aesc-silicon/ElemRV/software/elemrv_s/coremark/core_portme.h

/*
 * SPDX-FileCopyrightText: 2026 aesc silicon
 *
 * SPDX-License-Identifier: Apache-2.0
 */

#ifndef CORE_PORTME_H
#define CORE_PORTME_H

/* ElemRV-H is rv32i_zicsr: no F/D extension and no Zicntr, so floating point
 * is avoided entirely and timing comes from the machine timer instead of
 * mcycle. portable_fini() prints the raw tick count and the timer frequency so
 * the score can be recomputed at full precision on the host.
 */
#define HAS_FLOAT  0
#define HAS_TIME_H 0
#define USE_CLOCK  0
#define HAS_STDIO  0
#define HAS_PRINTF 0

#define COMPILER_VERSION "GCC" __VERSION__
#ifndef COMPILER_FLAGS
#define COMPILER_FLAGS FLAGS_STR
#endif
#define MEM_LOCATION "STACK"

typedef signed short   ee_s16;
typedef unsigned short ee_u16;
typedef signed int     ee_s32;
typedef double         ee_f32;
typedef unsigned char  ee_u8;
typedef unsigned int   ee_u32;
typedef ee_u32         ee_ptr_int;
typedef unsigned int   ee_size_t;
#define NULL ((void *)0)

#define align_mem(x) (void *)(4 + (((ee_ptr_int)(x)-1) & ~3))

#define CORETIMETYPE ee_u32
typedef ee_u32 CORE_TICKS;

#ifndef SEED_METHOD
#define SEED_METHOD SEED_VOLATILE
#endif

#ifndef MEM_METHOD
#define MEM_METHOD MEM_STACK
#endif

#ifndef MULTITHREAD
#define MULTITHREAD 1
#define USE_PTHREAD 0
#define USE_FORK    0
#define USE_SOCKET  0
#endif

/* No argc/argv from start.s, and _kernel() ignores the return value. */
#define MAIN_HAS_NOARGC   1
#define MAIN_HAS_NORETURN 0

extern ee_u32 default_num_contexts;

typedef struct CORE_PORTABLE_S
{
	ee_u8 portable_id;
} core_portable;

void portable_init(core_portable *p, int *argc, char *argv[]);
void portable_fini(core_portable *p);

#if !defined(PROFILE_RUN) && !defined(PERFORMANCE_RUN) \
	&& !defined(VALIDATION_RUN)
#if (TOTAL_DATA_SIZE == 1200)
#define PROFILE_RUN 1
#elif (TOTAL_DATA_SIZE == 2000)
#define PERFORMANCE_RUN 1
#else
#define VALIDATION_RUN 1
#endif
#endif

int ee_printf(const char *fmt, ...);

#endif /* CORE_PORTME_H */
