aesc-silicon/ElemRV/(commit log)

2024-12-31 Update Project
    * Move to Taskfile for better handling both FPGA/ASIC flows
    * Move ElemRV into this repository
    * Add manifest with all dependencies
    * Add github workflow to run minimal DRC checks
2025-02-12 Update to elements:v1.2
    * Update ORFS and Zibal in manifest
    * Switch from elements:v1.2 to v1.2
    * Add check-logs command to Taskfile
2025-03-05 hardware: elemrv: Update Board for Simulation
    Update HyperRAM and SPI Flash to proper simulate that chip.
2025-04-14 hardware: Update to ElemRV-N 0.2
    * Reduce clock from 25 to 20 MHz
    * Add pinmuxing with 20 general pins
    * Add more interfaces:
    * I2C Controller
    * PWM
    * PIO
    * Add masked AES accelerator
2025-04-14 hardware: elemrv: Update Demo Software
    Since the HyperBus controller got fixed, we can now run
    software in external HyperRAM.
    [kernel.c]
2025-12-04 Switch to Travis CI
    Move the "Check Design Flow from RTL to GDS" from GitHub
    to Travis CI.
    GitHub has only limited space size and this action is running
    out of space when installing the container.
2025-12-11 hardware: elemrv_h: Increase OCRAM to 8kB
    Switch from a 4 Macros to a 1 Macro SRAM macro. Additionally,
    increase the overall OCRAM size from 4 to 8kB.
2025-12-16 software: Switch to SPI XIP Quad IO protocol
    Switch as early as possible to the Quad IO protocol to
    improve the overall SPI bandwidth on the SPI XIP interface.
2025-12-16 manifest: Bump Nafarr and Zibal
    Include the SPI XIP Quad I/O protocol feature.
2025-12-17 hardware: elemrv_n: ECPIX5: Add SPI flash reset
    Add a reset generator for the external SPI flash.
2025-12-17 software: elemrv_n: Switch stack location to HyperRAM
    Switch the stack location from the internal OCRAM to the external
    HyperRAM.
    Also disable SPI Quad I/O for the Nitrogen architecture.
2025-12-18 hardware: ElemRV-*: ECPIX5: Add missing SPI rst signal
    This signal is required for the FPGA-based simulation.
2025-12-18 manifests: Bump Nafarr and Zibal
    * Add missing SRAM PDN to global PDN connection.
    * Improve SPI initial frequency from 1 to 5 MHz.
    * Simplify ECP5-based PLL interface.
2025-12-21 manifests: Remove gdsiistl
    We now have a Blender Add-on [1] to import GDSII files directly.
    Therefore remove gdsiistl because we don't need to convert the
    GDSII layout to STL first.
    1: https://github.com/aesc-silicon/BlenderGDS
2026-03-23 software: Add image container scripts
    Add scripts to generate an image container to boot from SPI flash.
2026-03-23 software: elemrv_n: Update bootrom
    * Enable SPI Quad I/O
    * Use different LED (then application)
    * Turn off all LEDs after relocating software
    * Add uart_putc for debugging
    * Decrease application size to reloacte faster
2026-03-23 hardware: Update ElemRV
    * Use new Clock and Reset Controllers
    * Use Edge enum instead of string
    * Move power and ground IO cells to top-level class
    * Rework clock handling
2026-03-24 Add manifest-tapeout-ihp-sg13cmos-2026-03-r1
    This revision brings several key updates to the ElemRV-N SoC:
    * Introduces a new L1 data cache and L1 instruction cache
    * Adds SPI support with Quad I/O protocol
    * Increases the chip clock frequency from 20 MHz to 60 MHz, with peripherals and CPU operating at 30 MHz
    * Migrates the bus architecture from ABMA to BMB and Wishbone
2026-05-03 Taskfile: TECH clean-up and new tasks
    Don't use TECH as BOARD name, add multiple new environment variables
    to support multiple PDKs. Also add metadata checks.
2026-05-03 Taskfile.firmware: Remove TECH and Clean-up
    Remove spaces around variables in {{ }}. Also replace TECH with board
    variable.
2026-05-03 software: ElemRV-H: Update Firmware
    * Add interrupt handling with UART loopback
    * Fix spi.layout (block size is larger)
    * Fill gen_image_container to generate a truncated image
    [kernel.c]
2026-05-03 hardware: ElemRV-H: Update Size and Clean-up
    * Reduce the die size by 18 %
    * Minor clean-ups that were missing from the last tape-out
    * Add rules.json
2026-05-04 software: elemrv_h: demo: Sync start.s
    Use "zero" when enabling XIP and add uart_putc as debug
    function.
2026-05-04 software: elemrv_h: Add bootrom
    Add the bootrom firmware back, because Zephyr currently can't
    enable XIP. It's also a cleaner boot process because Hydrogen
    and Nitrogen both use a bootrom.
2026-06-06 Fix Firmware Path
    Firmwares are now stored directly under build/<soc>/firmware because
    there should be no target specific changes. Therefore, they can live
    in a general directory. That also makes handling firmware binaries
    easier when using multiple boards in parallel (like FPGA + ASIC).
2026-06-06 Update ElemRV-H
    Switch the entire interconnect from BMB/Wishbone to TileLink for both
    the shared bus and all peripheral slave interfaces. This aligns ElemRV-H
    with the VexiiRiscv ecosystem and removes the legacy bus dependencies.
    Move the ASIC target from IHP SG13G2 to the lower-cost SG13CMOS5L
    process. Update IO cells, power pads, die/core area, and SRAM macro
    placement accordingly. The FPGA target (ECPIX5) is updated in parallel.
    Peripheral changes:
    - Migrate GPIO, UART, I2C, PIO, PWM, Pinmux from Wishbone to TileLink
    - Add system peripherals: Timer, Watchdog, ESM, Syscon
    - Add PRNG crypto peripheral
    - Add interrupt and error signal wiring for PIO, PWM, UART, PRNG
    - Rework PWM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
2026-06-06 hardware: elemrv_n: Address Nafarr/Zibal Changes
    The handling of interrupt count changed slightly in Zibal and PWM
    now has a sync and fault input signal, which should be tied to
    low by default.
2026-06-06 manifest: Bump Nafarr/Zibal + downgrade ORFS/IHP PDK
    Bump Nafarr to include the latest IP core updates with various
    improvements and TileLink support. Zibal adds a lot of changes
    to Hydrogen with a switch from BMB+Wishbone to TileLink and
    VexiiRiscv.
    Use ORFS and the IHP PDK from the Marc tape-out because both repos
    added support for CMOS5L.
2026-06-10 hardware: elemrv_h: Minor clean-up
    * Remove CRC32 import
    * Switch from genFPGASimConfig to genASICSimConfig from ASIC targets
    * Add ihpSramBlackboxes to replace generic memory against available
    IHP SRAM macros
    * Use parameter names in SoC Parameter
2026-06-10 hardware: elemrv_n: Switch from genFPGASimConfig to genASICSimConfig
    Switch from genFPGASimConfig to genASICSimConfig from ASIC targets
2026-06-11 hardware: elemrv_{h,c}: Add Reports
    The report tool generates RST tables for error, interrupt and
    pinmux options. Additionally, it generates a pinout JSON file.
2026-06-11 Update Travis Config
    Run most task for ElemRV-H, -C, and -N. Don't run the RTL to GDS
    flow since it takes too long.
2026-06-16 software: elemrv_h: Reduce bootrom size
    The Hydrogen bootrom only enables SPI Quad mode. Therefore,
    reduce the bootrom size to 4kB since that's enough for this
    task.
2026-06-19 docs: flows: chip: Remove fixed Known Issues
2026-06-19 docs: Add Virtual Prototyping
    Explain how to simulate, emulate and co-simulate a board to debug
    and develop software on virtual SoCs.
2026-06-19 podman-compose: Forward port 3456 for UART0
    Renode provides a socket with a virtual console. Forward this port
    to the host machine to allow running telnet and use the console.
2026-06-22 build: Select the ASIC target via TARGET instead of PDK/board
    The build was selected with PDK= and an implicitly derived `board`
    (e.g. SG13CMOS5L), which conflated the process node with a "board".
    Rework the model around explicit dimensions:
    - TARGET names the ASIC target (SG13CMOS5L, GF180MCU, SG13G2) and
    derives the PDK; the `board` variable is gone.
    - FPGA verification is a separate dimension: the FPGA board (ECPIX5)
    is nested under the target it verifies, both in the source tree
    (hardware/scala/<soc>/<TARGET>/ECPIX5/) and the build output
    (build/<SOC>/<TARGET>/fpga/<BOARD>/).
    - ECPIX5 tops are repackaged as <soc>.<TARGET>.ECPIX5* so multiple
    targets can each have their own FPG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
2026-07-03 Taskfile: Introduce flash namespace
    This namespace can flash a SPI flash via JTAG or flashrom
    (busbirate). It also uses smaller image sizes for JTAG and
    truncates the image to fit the SPI flash via flashrom.
2026-07-03 software: Generate 512kb images
    The total flash size is defined with 512kB in Zephyr.
    Generate images which fit this image size and truncate them
    later in case larger images are required.
2026-07-03 Taskfile: Add FLOORPLAN variable
    This variable allows to switch between a relaxed and tape-out
    floorplan. Relaxed increases the layout size and therefore improves
    the layouttime, while tape-out is more accurate.
2026-07-03 docs: Add flash namespace and FLOORPLAN variable
    Address all recent changes in the documentation to reflect the
    current tooling.
2026-07-03 hardware: ElemRV-N: Add SPI reset signal
    Make sure ElemRV-N still compiles without properly connect the
    SPI reset signal.
    ElemRV-N will be updated next.
2026-07-03 hardware: Update ElemRV-H
    * Decrease general-purpose pins from 12 to 11
    * Add SPI reset pin to reset the ext. SPI flash
    * Add reset domain to release SPI reset before CPU reset
    * Switch both 4kB SRAM macros against a single 8kB one
    * Increase debug clock domain to mach system
    * Add relaxed floorplan
2026-07-03 hardware: Update ElemRV-C
    * Place i-cache as memory (tag and data)
    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
2026-07-22 Taskfile: asic: Add precondition for build
    Print a useful error message whenever the SoC metadata
    are not existing.
2026-07-22 Taskfile: Add configurable chip top-cell name via TOPCELL
    Introduce a TOPCELL variable (default "<TARGET>Top") threaded through the
    container env into ORFS and the SpinalHDL generators, allowing the whole
    design top cell - Verilog module, DESIGN_NAME/DESIGN_NICKNAME, results dir,
    --topcell and generated files - to be renamed from one place. Apply it in the
    ElemRV-H and ElemRV-C generators via setDefinitionName + setTopCellName.
2026-07-22 Taskfile: sim: Add precondition
    Print a useful error message whenever the firmware is missing when
    running the emulation, co-simulation or simulation tasks.
2026-08-25 Taskfile: Rework debug, flash, and FPGA flows
    - jtag: add server (OpenOCD gdb:3333 + telnet:4444), telnet, and flash
    tasks, plus a debug task that attaches GDB over JTAG.
    - Fold the standalone flash Taskfile into jtag (SPI-NOR flashing via
    OpenOCD).
    - fpga: add mode=spi to program the external SPI flash (default loads
    volatile SRAM).
    - sim: gate on the generated cosim peripheral manifest (peripherals.tsv)
    with a clear "run asic:prepare first" message.
    - Add SPDX headers / task schema to the reworked files.
2026-08-25 hardware: elemrv_{h,c}: Move HyperRAM/SPI flash sim import
    The HyperRAM and SPI flash simulation objects moved from Zibal to
    Nafarr to allow round-trip tests with each controller.
2026-08-25 hardware: Update ElemRV-H and -C for the Nitrogen rework
    Bring the -C and -H SoC tops (and their FPGA/cosim configs) back in
    line with the shared platform changes:
    - Repoint imports to the relocated Nafarr models: ocram
    TileLinkIhpOnChipRam (tech-agnostic path) and spi MT25Q.
    - Declare the asynchronous clock groups via setAsynchronousClocks
    (clk_main / clk_jtag / clk_debug).
    - Emit the Renode co-simulation manifest with
    RenodeTools.dumpCosimManifest.
    - Fix the Renode .resc/.repl: privilegedArchitecture typo, and drop the
    hand-written per-peripheral SimulationFilePathLinux bindings now
    provided by the manifest.
    [kernel.c]
2026-08-25 software: Fix interrupt handling in bare-metal demos
    The interrupt handler in the bare-metal demo application was not
    working for any platform anymore. Add general fixes, enable the
    GPIO interrupt again with a configurable input pin with a better
    print.
    [kernel.c]
2026-08-25 manifests: Drop vexriscv
    ElemRV is not using vexriscv anymore and entirely switched to
    VexiiRiscv. Remove it from the manifest.
2026-08-30 manifest: Bump Zibal
    3ae591c Bump scalafmt to 2.4.6
    8aeb6ed Add Nafarr as external project
    d97ab41 eda: Lattice: Harden FPGA synthesis flow
    e56c563 Make Repo easier for contributions
    19e42bb Taskfile: lib-sealring: Swap width/length
2026-09-02 ElemRV-{H,C,N}: Add CoreMark support
    Generate the soc.h also for the "coremark" firmware and add the
    "coremark" firmware for each SoC.
    Also don't generate a soc.h file for the ElemRV-N "bootrom"
    firmware, since it doesn't require those information.
    [core_portme.c, core_portme.h, kernel.c]
2026-09-02 hardware: elemrv_{h,c,n}: Switch to TileLinkOnChipRam
    Since SpinalHDL can now map generic Mem() components to existing
    IHP SRAM macros, there is no need for a dedicated
    TileLinkIhpOnChipRam IP. Additionally, this IP lacks burst access
    and ElemRV-C and -N can't run code from the internal OCRAM.
2026-09-02 manifest: Bump Zibal
    e3e011d Bump Nafarr
    0d7173c Taskfile: lib-baremetal-firmware: Make Makefile path configurable
    addbd21 hardware: zibal: platform: Hydrogen: Rename bus parameter in SPI XIP area
    c92aa2e hardware: zibal: platform: Carbon: Remove SpiCache
    2e42fe7 software: baremetal: Makefile: Add default GCC
    09b9669 software: Add coremark
2026-09-16 hardware: elemrv_n: Switch to TileLinkOnChipRam
    Fixes 2636e63a51a153653360d8942574ab06146a8330
    and ElemRV-N can't run code from the internal OCRAM.
    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
2026-09-29 Taskfile: asic: Switch internal task for "fill"
    The internal task to add metal dummy fill got renamed in Zibal
    from lib-filler to lib-gdsfill to represent the used tool.
2026-09-29 hardware: elemrv_h: Extend the SPI flash reset to 1024 cycles
    A software reset through the reset controller holds the flash domain
    in reset for exactly the configured delay. With 256 cycles the SPI
    flash intermittently did not respond to the first XIP fetch after a
    reboot on ECPIX5, while the longer reset triggered by the debug module
    worked. 1024 cycles made the reboot reliable.
    The flash is still released well before the system domain (4096
    cycles).
2026-09-29 hardware: elemrv_c: Extend the SPI flash reset to 1024 cycles
    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
2026-09-29 hardware: elemrv_n: Extend the SPI flash reset to 1024 cycles
    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
2026-09-30 hardware: elemrv_h: Fix PLIC sources in Renode platforms
    The platform adds the timer, watchdog and ESM interrupts first (PLIC
    sources 1 - 3), followed by the SoC peripherals from source 4. The
    Renode platforms started the peripherals at source 3 and routed the
    watchdog to source 1. Match the generated soc.h: GPIO0 = 4, I2C0 = 5,
    PIO0 = 6, PWM0 = 7, UART0 = 8 and watchdog = 2.
2026-09-30 hardware: elemrv_c: Fix PLIC sources in Renode platforms
    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
2026-09-30 hardware: elemrv_n: Fix timer and watchdog PLIC sources in Renode platforms
    The platform adds the timer interrupt before the watchdog, so the timer
    is PLIC source 1 and the watchdog source 2, as in the generated soc.h.
    The co-simulation platform had both swapped, and the source order
    comment of the emulation platform listed them the same way.
2026-09-30 hardware: elemrv_n: Use the Nitrogen board parameter
    The SG13CMOS5L target used ElemRVFlask.Hydrogen.Parameter, whose 50 MHz
    oscillator did not match the 60 MHz Nitrogen reference clock the target
    derives its clocks from. Use ElemRVFlask.Nitrogen.Parameter.
2026-09-30 Taskfile: zephyr: Allow SoCs without a Zephyr board
    The zephyr_board variable is evaluated for every task, so an SoC
    without a Zephyr board failed all tasks, not only zephyr:compile.
    Return an empty board name instead and let zephyr:compile fail with a
    precondition.
2026-09-30 manifest: Bump Zibal
    607d18f Bump Nafarr
    11dc38c openocd: Add Oxygen
    fb509b0 hardware: renode: cosim: Skip DMA controller
    ecb34f1 hardware: zibal: platform: nonmetals: Add Oxygen platform
    ebacc6a hardware: zibal: misc: BaremetalTools: Add DMA request lines
    139d245 hardware: zibal: platform: Build syscon after all IPs are added
2026-09-30 hardware: elemrv_o: Add ElemRV-O
    Add ElemRV-O, a copy of ElemRV-N based on the Oxygen platform: the CPU
    adds atomics (A), bit manipulation (Zba/Zbb/Zbc/Zbs) and Zicbom, and a
    DMA controller serves eleven request lines of the I2C, SPI, UART and PIO
    controllers, which soc.h lists as <NAME>_DMA_TX/RX. The DMA interrupt
    takes PLIC source 4, so the SoC peripherals move up by one.
    The SG13CMOS5L tapeout floorplan is 7% larger than ElemRV-N's: with the
    ElemRV-N area, ElemRV-O reached 83% density at the floorplan stage.
    The Renode platforms use the extended ISA and do not model the DMA; the
    co-simulation build skips it. There is no Zephyr support; bare-metal
    firmware builds with the new ISA string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
    [core_portme.c, core_portme.h, kernel.c]
2026-09-30 software: elemrv_o: Use the DMA for relocation and the boot banner
    The boot ROM copies the application image from flash to HyperRAM with
    DMA channel 0 (_relocate_dma), and the demo sends its banner to UART0
    with byte elements paced by the UART0 TX request line. Both check the
    DMA info register first and fall back to the CPU when it reports no
    channels or a transfer fails.
    The banner moves to .rodata, which the boot ROM copies before the CPU
    caches it, so the DMA reads the same bytes without cache maintenance;
    the demo linker script now collects .rodata.* as well.
    The Renode platforms map zeroed DMA registers, so the firmware takes
    its CPU paths there without unmapped-access warnings. The E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
    [kernel.c]
2026-10-01 manifest: Bump Zibal
    d7c7b09 hardware: zibal: platform: Add SWD option to Oxygen, Phosphorus, Sulfur
    49b0adf hardware: elements: board: Add ElemRVFlaskULX3S
    754cba4 hardware: zibal: platform: Add SWD debug transport option
    6c66058 software: Make the ABI and ELF format configurable
    6cc46cd openocd: Add Phosphorus and Sulfur
    d5c1a06 hardware: zibal: platform: nonmetals: Add Sulfur platform
    9ff7c97 hardware: zibal: platform: nonmetals: Add Phosphorus platform
    c0f1895 Bump Nafarr
2026-10-01 hardware: elemrv_p: Add ElemRV-P
    Add ElemRV-P, a copy of ElemRV-O based on the Phosphorus platform: the
    CPU issues two instructions per cycle and the memory side of the
    interconnect is 64 bits wide. Caches, DMA, on-chip SRAM, HyperBus and
    SPI XIP move 64-bit beats, the CPU I/O bus is widened to 64 bits, and a
    width adapter keeps the peripheral bus at 32 bits. ISA, peripherals,
    pinmux, DMA request lines and firmware are unchanged.
    The IHP SRAM macros have no dual-port 512x64 variant, so the 64-bit
    cache data banks are built from standard cells. The 512 byte GShare of
    Phosphorus maps to a 2P 256x16 macro. The SG13CMOS5L floorplan places
    only the mapped memories as macros and keeps the ElemRV-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
    [core_portme.c, core_portme.h, kernel.c]
2026-10-01 software: Add common console and system info helpers
    Add software/common, shared by the demos of all SoCs and compiled
    through the COMMON directory of Zibal's bare-metal Makefile:
    - console: print functions on top of the UART driver, including decimal,
    hexadecimal and UNIX timestamp output.
    - sysinfo: print_banner() prints the SoC name; print_system_info()
    prints the syscon identity (vendor, product, silicon revision,
    platform and class), the build date, the reference clock, the ISA and
    privilege modes from misa, and the IP cores the syscon reports.
    misa only lists single-letter extensions; Zba, Zicbom and the other
    Z extensions have no M-mode discovery register and are not shown.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
2026-10-01 software: Print system info in the ElemRV-H, -C, -N, -O, -P and -S demos
    Print the banner with the common helpers and show the system info
    before the prompt.
    ElemRV-H, ElemRV-C and ElemRV-N print the banner from the CPU.
    ElemRV-O, ElemRV-P and ElemRV-S keep sending it over DMA; their local
    function is renamed to print_banner_dma() so that it does not clash
    with the common print_banner().
2026-11-09 hardware: elemrv_c: Add Tsetlin machine
    Add the Nafarr Tsetlin machine with a 64 x 80 Muninn clause array and
    six classes at 0xF0006000, interrupt source 9.
    SG13CMOS5L builds it as a separate block (TileLinkTsetlin) around the
    conservative hard macro and places it rotated by 180 degrees in the
    bottom-right core corner, so its ports face the core. The die grows by
    60 um in both directions. The Metal4 stripe offset, the on-chip RAM and
    the cache tag RAM move to clear PDN warnings and a routing hotspot next
    to the block.
    ECPIX5 uses the flop-based clause array, and the Renode platform gets
    the TsetlinCtrl model.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
2026-11-09 software: elemrv_c: demo: Add a Tsetlin command console
    Classify the UART console's command lines on the Tsetlin machine:
    each line is hashed into character bigrams, searched in one cycle, and
    the winning class runs help, version, led on, led off or clear. Typos
    are tolerated, unknown commands are rejected. The model
    (console_64x80.h) comes from muninn-reference-models.
